VisteK528/PIAR_Mainboard/docs/PIAR_MainBoard.step

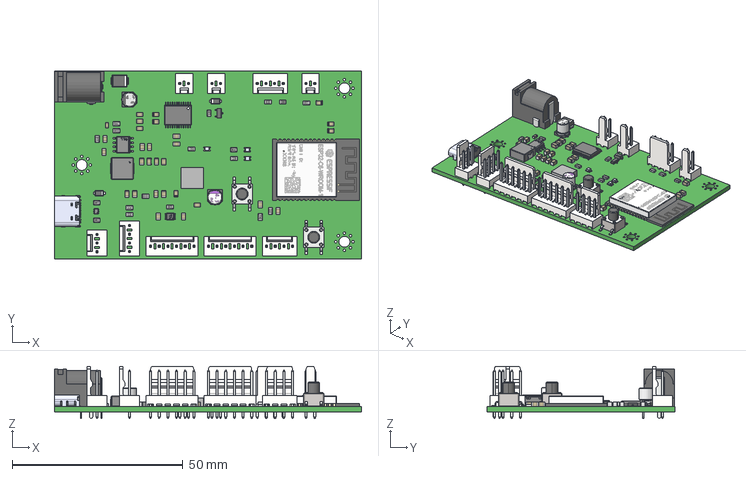
[picture p1: CAD file, 2025-04-24]
docs/PIAR_MainBoard.step
90.0 x 55.0 x 15.3 mm
