VisteK528/PIAR_Mainboard/docs/PIAR_MainBoard.pdf

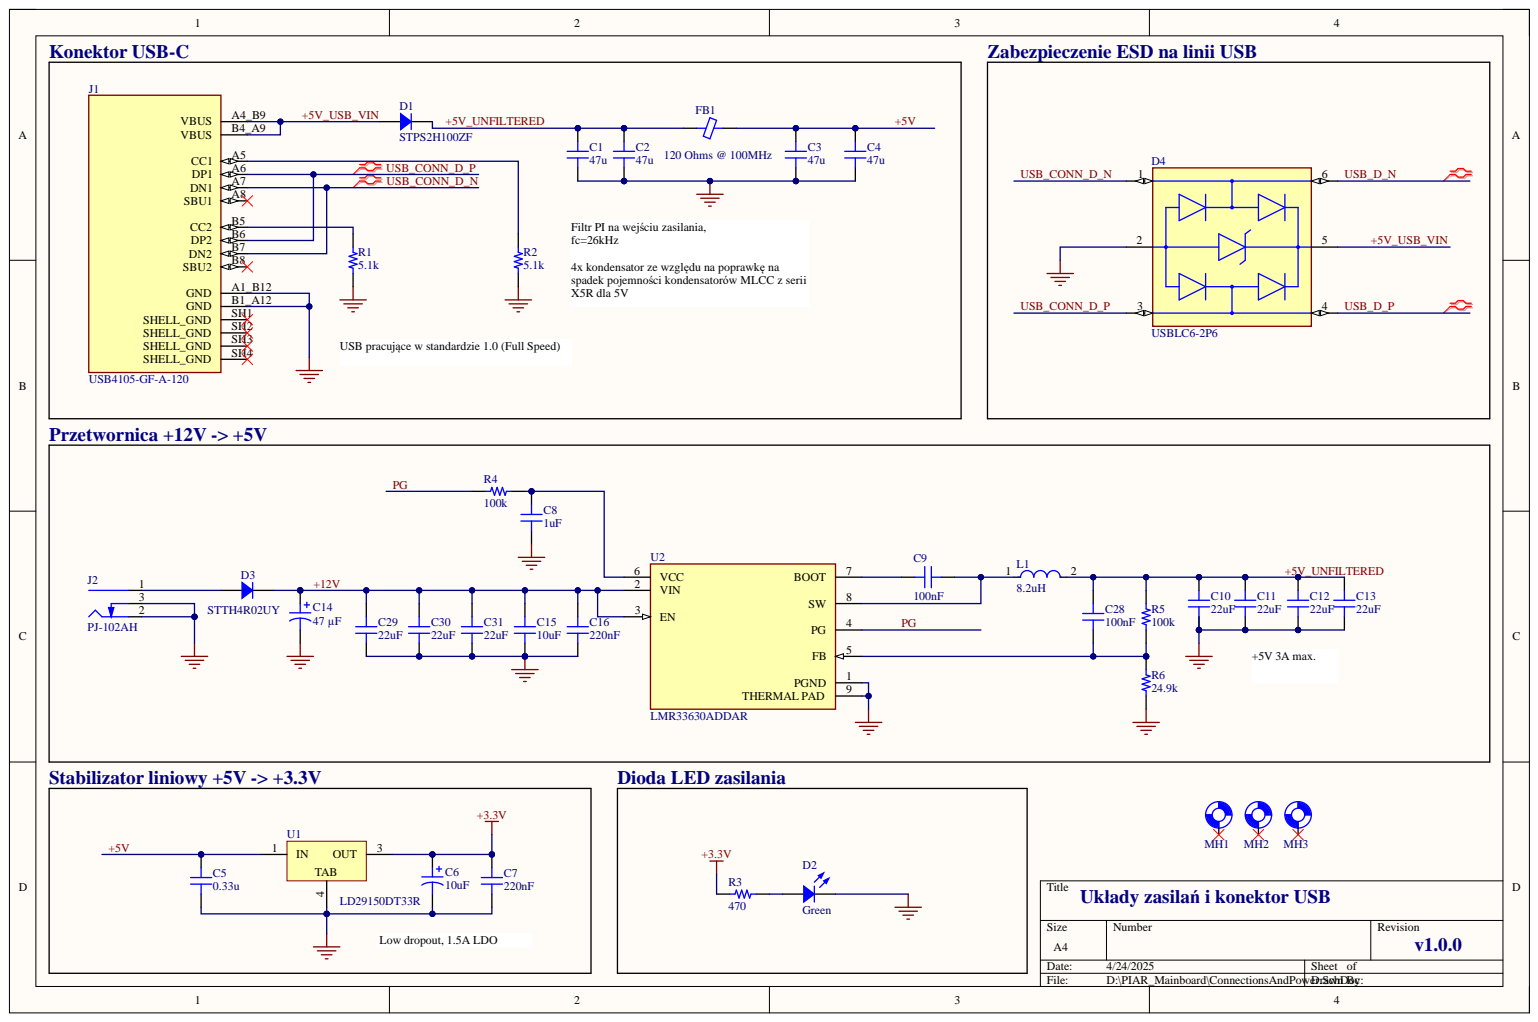
[picture p2: page 1]

Filtr PI na wejściu zasilania,
fc=26kHz

4x kondensator ze względu na poprawkę na
spadek pojemności kondensatorów MLCC z serii
X5R dla 5V

USB pracujące w standardzie 1.0 (Full Speed)

Title
Układy zasilań i konektor USB

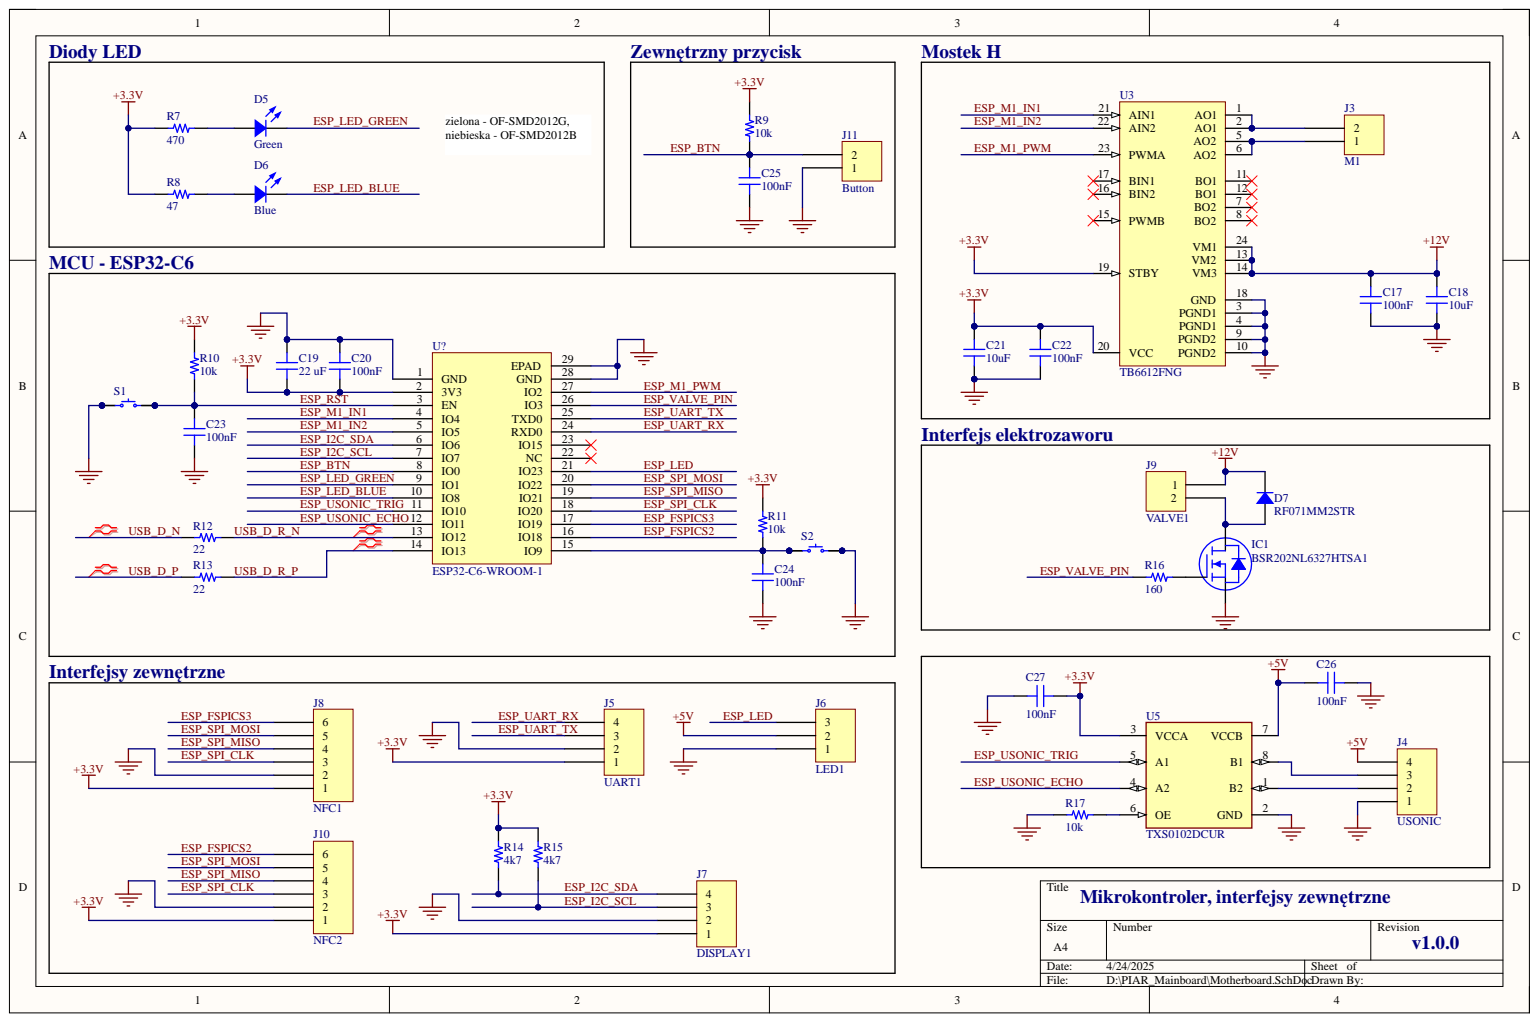
[picture p3: page 2]
