VisteK528/PIAR_Mainboard/(list of files, drawings)

Other design files:
ConnectionsAndPower.SchDoc
Motherboard.SchDoc
PIAR_MainBoard.PcbDoc
PIAR_MainBoard.PrjPcb
