VisteK528/PIAR_Mainboard/(threads)

Thread 1 (2025-04-20):

PIAR motherboard v1.0.0 fixes

VisteK528, 2025-04-20:
# Fixes
1. - [ ] Placement of additional ceramic capacitors on input of converter (0805 3x22uF).
2. - [ ] Connect GND of outputs capacitors via direct polygon.
3. - [ ] R5 resistor on feedback line of converter should be placed horizontally to reduce length of feedback close loop.
4. - [ ] GND connection to GND plane on bottom layer using via for +5V decoupling capacitor of level shifter
5. - [ ] Addition of capacitor on feedback line (don't have to be soldered finally, but it's better to have place for it so there is some possibility to solve instability of converter)
6. - [ ] Other USB-C components (current is not available on TME)
