VisteK528/PIAR_Mainboard/(commit log)

2025-04-13 First version of PIAR motherboard
    [ConnectionsAndPower.SchDoc, Motherboard.SchDoc, PIAR_MainBoard.PcbDoc, PIAR_MainBoard.PrjPcb, Power.SchDoc]
2025-04-14 Added ext btn interface, fixed some traces, generated docs
    [ConnectionsAndPower.SchDoc, Motherboard.SchDoc, PIAR_MainBoard.PcbDoc, PIAR_MainBoard.PrjPcb]
2025-04-15 Removed one DC motor output, added ultrasonic sensor connector, added flyback diode to electovalve circuit
    [Motherboard.SchDoc]
2025-04-24 #1, other fixes, exported docs and .step file
    [ConnectionsAndPower.SchDoc, PIAR_MainBoard.PcbDoc, PIAR_MainBoard.PrjPcb, PIAR_MainBoard.step]
